Hao-Xuan/Reactor-Bike-Light/Mechanical/Media/reactor_physical.PNG

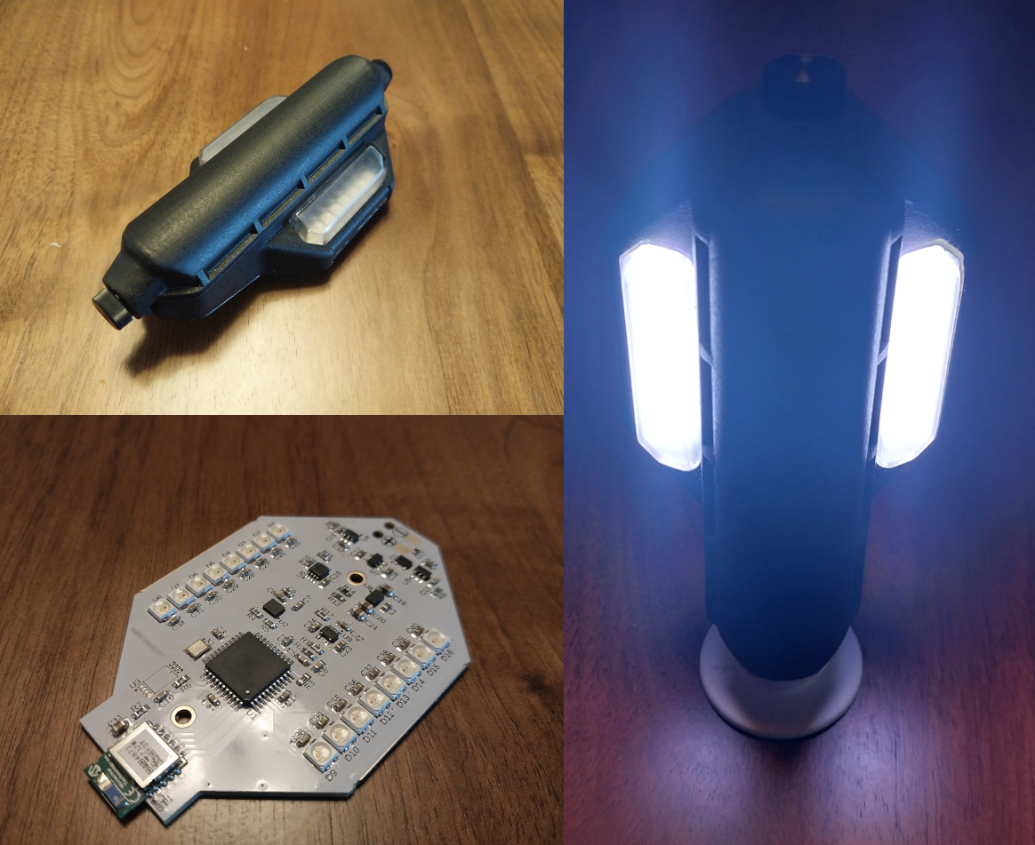
Mechanical/Media/reactor_physical.PNG
