Hao-Xuan/Reactor-Bike-Light/Electronics/Media/reactor_Prod_Dev.jpg

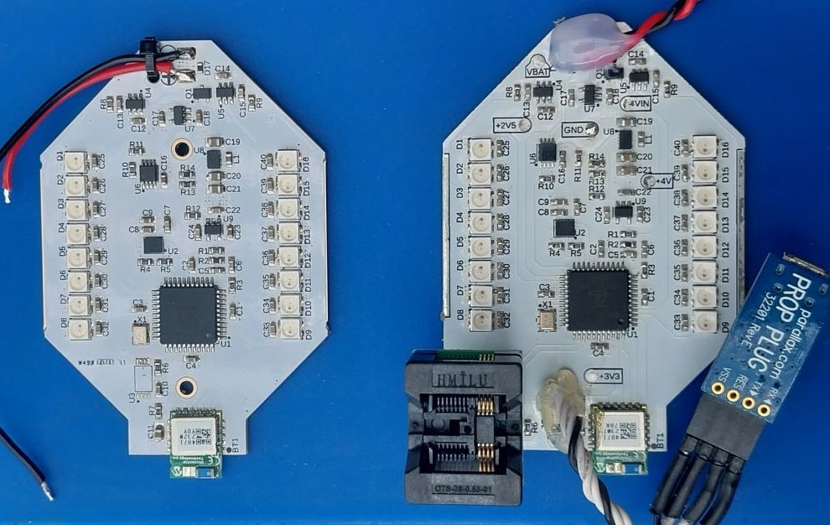
Electronics/Media/reactor_Prod_Dev.jpg
