Hao-Xuan/Reactor-Bike-Light/Electronics/readme.md

# Electronics

---
## Architecture Summary

The architecture of Reactor's electronic system was developed to support three primary responsibilities: sensing the motion of the bicycle, controlling the lighting system in real time, and communicating with external devices. These responsibilities place very different demands on the hardware. Motion sensing requires clean power and reliable timing. Wireless communication requires its own dedicated radio subsystem. High-power LED operation requires significantly more energy than the rest of the electronics combined.

To accommodate these competing requirements, the system was divided into functional subsystems organized around four power domains. This architecture simplified development and debugging while allowing the sensing, communications, control, and lighting hardware to evolve independently as the design matured. This architecture also supports Reactor's low-power operating modes by allowing portions of the system to remain active only when required.

The block diagram in Figure 1 below provides a high-level view of the electronic architecture and the relationships between its major subsystems.

reactor_Electronics_Block_Diagram

**Figure 1** - System architecture showing the four functional power domains and their major hardware subsystems

### 🔵 Power Source

The Power Source block consists of a removable lithium-ion battery and the circuitry required to safely interface that battery to the rest of the system. The removable battery design allows riders to replace depleted cells and continue riding without waiting for a recharge cycle. Input protection circuitry guards the electronics against common fault conditions and provides a stable entry point for power distribution throughout the device.

### 🟢 Always-On Domain

The Always-On Domain provides the circuitry to monitor rider input and initiate system startup. It remains powered whenever a battery is installed and operates independently of the rest of the system. This arrangement allows Reactor to remain responsive while minimizing standby power consumption, since the lighting system and control electronics only need to be energized when the rider requests them.

### 🔴 High-Power Domain

The High-Power Domain serves as the primary operating power domain for Reactor. Once activated by the Always-On Domain, it supplies power to the lighting system and to the control electronics responsible for sensing, communications, and system coordination. This arrangement allows the majority of the hardware to remain unpowered when inactive while still supporting rapid startup when rider input is detected.

### 🟡 Control Domain

The Control Domain contains the circuitry responsible for sensing, computation, communications, data storage, battery monitoring, and system coordination. It receives power from the High-Power Domain and remains active only while the lighting system is operating. This arrangement provides a stable regulated supply while ensuring that the control electronics consume no power when the system is inactive.

---
## Domain Details

### 🔵 Power Source

The Power Source block provides energy to the entire system and protects downstream electronics from battery-related fault conditions. All power enters the PCB from a battery and passes through a small protection stage before reaching the remainder of the system. Figure 2 shows the schematic snippet for both subsystems.

schematic_Power_Source

**Figure 2** - Power Source circuitry showing the removable battery interface and input protection stage

#### Removable Li-ion Battery

Reactor is powered by a single rechargeable lithium-ion cell in the 18650 form factor. The 18650 was selected for its combination of energy density, availability, low cost, and well-established ecosystem of chargers and replacement cells.

A removable battery was chosen instead of an integrated rechargeable pack to improve usability during normal operation. Riders can carry spare cells and replace a depleted battery in seconds rather than waiting for the device to recharge. This approach also simplifies long-term maintenance, since battery capacity naturally degrades over time and replacement does not require disassembling the electronics.

#### PCB Input Protection

The PCB Input Protection subsystem forms the interface between the battery and the rest of Reactor's electronics. Battery voltage first passes through a transient voltage suppression diode that protects the circuit from electrostatic discharge events that may occur during battery handling, insertion, or removal.

Because Reactor uses removable batteries, incorrect installation must be considered a normal operating scenario rather than an exceptional event. A power MOSFET configured for reverse-polarity protection prevents damage if a battery is installed incorrectly.

The protected output of this stage appears at `VIN`, which serves as the entry point for the remainder of Reactor's power distribution system.

### 🟢 Always-On Domain

The Always-On Domain provides the circuitry required for Reactor to remain responsive while inactive. Unlike the remainder of the system, which is unpowered when the bike light is off, the Always-On Domain remains active whenever a battery is installed. The Always-On Domain consists of two primary subsystems: the touch sensing circuitry used to detect rider input and the wakeup logic responsible for enabling the rest of the electronic system. Figure 3 shows the schematic snippet for the Always-On Domain.

schematic_Always_On

**Figure 3** - Always-On Domain showing standby power, touch sensing, and wakeup logic

#### Power Distribution

The Always-On Domain is powered by a dedicated 2.5V supply generated directly from the lithium-ion battery through a low-dropout linear regulator which is always enabled. A regulator was selected to maximize the usable battery discharge range while minimizing standby power consumption. Its low quiescent current allows the Always-On Domain to remain active for extended periods without significantly affecting battery life, while providing sufficient dropout margin to maintain regulation throughout the normal operating range of a single lithium-ion cell.

#### Dual Touch Sensors

Rider input is detected by dual sensing pads integrated into the left and right sides of the PCB and bonded  to the inside of the mechanical enclosure. Each pad is continuously monitored by a dedicated touch controller IC that produces a digital output when a touch is detected. These outputs appear as the `TOUCH_A` and `TOUCH_B` signals, which are used by the Always-On Domain to initiate system startup and later by firmware to interpret rider commands.

Capacitive sensing was selected because it provides a sealed user interface with no mechanical buttons or switches. This improves durability in outdoor environments and eliminates openings that would otherwise complicate weather resistance.

#### Wakeup Logic

The Wakeup Logic subsystem controls the transition between Reactor's standby and operating states.

A simultaneous touch on both sensing pads generates the `+4V_EN` signal, enabling the High-Power Domain. Requiring both sensors to be activated reduces the likelihood of accidental startup while still providing a simple power-on gesture. Once the system has started, control of the power state is transferred to firmware through the `POWER_EN` signal. This allows the microcontroller to keep the system powered after the original touch event has ended and later return the device to standby when appropriate.

By separating wakeup detection from normal operation, Reactor remains responsive while consuming very little power when inactive. The rider experiences immediate startup, while the majority of the electronics remain unpowered until needed.

### 🔴 High-Power Domain

The High-Power Domain provides the regulated power required for normal system operation. Once enabled by the Always-On Domain, it supplies energy to both the lighting system and the control electronics responsible for sensing, communications, and system coordination.

In addition to power conversion, this domain manages the startup sequence that brings the remainder of the system online and ensures that downstream circuitry receives stable operating voltages across the full battery discharge range. Figure 4 shows the schematic snippet for the High-Power Domain power distribution circuitry.

schematic_High_Power_Regulator

**Figure 4** - High-Power Domain power distribution and startup sequencing
#### Power Distribution

The High-Power Domain is enabled through the `+4V_EN` signal generated by the Always-On Domain. Once asserted, a buck/boost regulator produces the primary 4.0V supply that powers both LED arrays directly.

A buck/boost topology was selected because the voltage of a single lithium-ion cell varies substantially throughout its normal discharge cycle. This allows the regulator to maintain a constant 4.0V output whether the battery voltage is above or below the target net voltage, ensuring consistent LED performance across the full operating range of the battery.

In addition to powering the LED arrays, the regulated 4.0V regulator supplies the downstream 3.3V regulator that supplies the Control Domain.

#### Dual LED Arrays

The lighting system consists of two independent chains of addressable RGB LEDs. Each array contains eight LEDs and is controlled independently by firmware through dedicated single-wire serial data connections `LED_A` and `LED_B`. Figure 5 shows the schematic snippet for both LED arrays.

schematic_High_Power_LEDs

**Figure 5** - Dual independently controlled addressable LED arrays

Addressable LEDs were selected because they integrate the LED drivers and communication interface into a single package. This significantly reduces component count and routing complexity compared to a discrete LED implementation, while providing individual color and brightness control of every LED. The resulting flexibility allows a single hardware platform to support head, tail, and ground light modes as well as brake, turn, and hazard indications entirely through firmware.

The arrays are powered directly from the regulated 4.0V supply and arranged as independent serial chains, allowing each array to operate independently when required. Each LED includes local bypass capacitance to reduce supply disturbances caused by rapid switching of the internal LED drivers.

### 🟡 Control Domain

The Control Domain contains the circuitry responsible for sensing, computation, communications, persistent storage, and battery monitoring. Operating from the regulated 3.3V supply, it serves as the central coordination point for Reactor's electronic system.

At its heart is a multicore microcontroller that acquires sensor data, executes the control algorithms, manages wireless communications, stores configuration data, monitors battery condition, and generates the commands transmitted to the LED arrays. Supporting peripherals provide motion sensing, wireless connectivity, non-volatile storage, and battery measurement capabilities.

#### Power Distribution

The Control Domain is powered from a dedicated 3.3V low-noise linear regulator sourced from the High-Power Domain's 4.0V supply. This regulator provides a clean, stable supply for the microcontroller, inertial measurement unit, wireless communications module, battery monitor, and persistent memory. Figure 6 shows the schematic snippet for the Control Domain power supply.

schematic_Control_Domain_LDO

**Figure 6** - Control Domain 3.3 V power distribution and startup sequencing

The 3.3 V regulator is enabled by the ``+3V3_EN`` signal, which is driven by the power-good (PG) output of the 4 V regulator. During 4 V startup, the PG output is held low, keeping the 3.3 V regulator disabled. Once the 4 V output has stabilized, PG releases to its open-drain state and an external pull-up resistor drives ``+3V3_EN`` high, enabling the 3.3 V regulator.

#### Microcontroller

The microcontroller coordinates every function within Reactor's electronic system. It receives sensor data from the inertial measurement unit, processes rider input from the touch sensors, manages wireless communications, monitors battery condition, retrieves configuration data from non-volatile memory, and generates lighting commands for the LED arrays. Figure 6 shows the microcontroller and its supporting circuitry, including the external crystal oscillator and local decoupling network required for reliable operation.

schematic_Control_Domain_MCU

**Figure 7** - Propeller microcontroller and supporting circuitry

The Propeller P8X32A serves as the central controller for Reactor. The device provides eight independent processing cores that share access to memory and I/O resources, allowing sensing, communications, lighting control, and system management tasks to execute concurrently.

Unlike most modern microcontrollers, the Propeller provides only a minimal set of hardware peripherals. As a result, many low-level system functions were implemented directly in software. Communication interfaces, LED signaling, timing infrastructure, battery measurement, and subsystem coordination were all developed as bare-metal firmware components tailored to the requirements of the project.

This approach required a deeper understanding of both the hardware and firmware layers of the system but also provided complete control over timing behavior and resource allocation. The resulting architecture allowed motion sensing, wireless communications, power management, and lighting control to operate simultaneously while maintaining deterministic system behavior.

#### Inertial Measurement

The inertial measurement unit (IMU) provides the motion data that allows Reactor to respond automatically to changing riding conditions. It continuously measures linear acceleration and angular velocity, providing the information required to detect braking, turning, crashes, and changes in bicycle orientation. Figure 7 shows the IMU and its supporting circuitry.

schematic_Control_Domain_IMU

**Figure 8** - Inertial measurement subsystem

The IMU communicates with the microcontroller over an I²C interface and serves as the primary sensing device within Reactor. An interrupt output provides a dedicated hardware signal for communicating time-critical events to the microcontroller, while pull-up resistors on the I²C bus ensure reliable communication between the two devices.

Because many of Reactor's safety features depend on accurate motion measurements, the IMU was supplied by the dedicated low-noise 3.3 V regulator within the Control Domain. Local decoupling capacitors were placed adjacent to the device to maintain a stable supply during operation and minimize high-frequency supply disturbances.

The hardware provides only the raw motion data. Filtering, sensor fusion, coordinate transformations, and motion classification algorithms that convert these measurements into lighting behavior are implemented entirely in firmware and are described in the Firmware documentation.

#### Radio Communications

The Bluetooth Low Energy (BLE) subsystem provides wireless communication between Reactor and the companion mobile application. Through this interface, riders can configure device behavior, monitor battery status, and receive crash notifications without requiring a wired connection. Figure 8 shows the BLE module and its supporting circuitry.

schematic_Control_Domain_BLE

**Figure 9** - Bluetooth Low Energy communications subsystem

Wireless communication is provided by a self-contained BLE module that integrates the radio, protocol stack, and application processor into a single package. Using a pre-certified module significantly reduced hardware complexity and eliminated the need to develop a custom RF design.

The module communicates with the microcontroller through a UART interface. A dedicated`BLE_RST` signal allows firmware to place the module in a known state during startup and recover from communication faults if necessary. Two configurable GPIO outputs are connected to the microcontroller as`BLE_P1_6` and`BLE_P1_7`, providing simple hardware status signals that reduce firmware polling overhead. The remaining module I/O pins are unused and tied to their recommended default states in accordance with the manufacturer's reference design.

#### Battery Monitor

The Battery Monitor subsystem measures battery voltage so firmware can estimate remaining charge, report battery status to the rider, and notify the rider when the battery requires replacement or recharging. Figure 9 shows the analog front-end used to interface the battery to the microcontroller.

schematic_Control_Domain_ADC

**Figure 10** - Battery monitoring analog front-end

Battery voltage is reduced to a safe measurement range by a resistor divider before being presented to the microcontroller. RC filtering removes high-frequency noise and switching transients from the supply, improving measurement stability during normal operation.

Because the Propeller P8X32A does not include a hardware analog-to-digital converter, battery voltage is measured using the device's built-in sigma-delta counter mode. The filtered divider output is connected to the measurement input `ADC_M`, while a second GPIO `ADC_P` provides the feedback signal required by the sigma-delta conversion circuit. This approach provides a simple, low-cost method of measuring battery voltage without requiring an external ADC.

#### Persistent Memory

The Persistent Memory subsystem provides non-volatile storage for both Reactor's application firmware and user configuration data. Unlike many modern microcontrollers, the Propeller P8X32A contains no internal program flash. Instead, its built-in bootloader retrieves the application image from an external I²C EEPROM during every system startup. Figure 10 shows the EEPROM interface circuitry.

schematic_Control_Domain_EEPROM

**Figure 11** - Persistent memory subsystem

The EEPROM is connected to the microcontroller through a dedicated I²C interface that is separate from the inertial measurement unit. This isolates program memory accesses from motion sensor communications while allowing firmware to read and write persistent data whenever required.

A dual-bank EEPROM was selected to support safe firmware updates. New firmware images are written to the inactive memory bank before replacing the active application, reducing the risk of rendering the device inoperable if power is interrupted during the update process.

In addition to storing the application firmware, unused EEPROM space is used to retain configuration data across power cycles. Rider preferences, lighting configuration, and other operating parameters remain intact even when the battery is removed, eliminating the need to reconfigure the device after normal battery replacement.

---
## PCB Layout

The Reactor PCB was designed as a compact four-layer board that integrates the lighting, sensing, power management, and communications subsystems into a single assembly. Component placement, routing, power distribution, and thermal management were considered together to support reliable operation while conforming to the mechanical constraints of the enclosure. The resulting layout separates high-current lighting circuitry from the control electronics while providing continuous ground planes, dedicated internal power distribution, and integrated capacitive touch electrodes. Figure 12 shows the annotated view of this layout.

PCB_Annotated

| Domain | Reference | Module |
|:---|:---:|:---|
| 🔵 **Power Source** | **P1** | Removable Li-ion Battery |
| 🔵 **Power Source** | **P2** | PCB Input Protection |
| 🟢 **Always-On** | **A1** | Always-On Supply |
| 🟢 **Always-On** | **A2** | Dual Touch Sensors |
| 🟢 **Always-On** | **A3** | Wakeup Logic |
| 🔴 **High-Power** | **H1** | High-Power Supply |
| 🔴 **High-Power** | **H2** | Dual LED Arrays |
| 🟡 **Control** | **C1** | Control Supply |
| 🟡 **Control** | **C2** | Battery Monitor |
| 🟡 **Control** | **C3** | Microcontroller |
| 🟡 **Control** | **C4** | Radio Communications |
| 🟡 **Control** | **C5** | Inertial Measurement |
| 🟡 **Control** | **C6** | Persistent Memory |

**Figure 12** - Annotated PCB layout showing the locations of the major electronic subsystems

### Layer 1 – Component Placement and Signal Routing

pcb_Layout_Full_Top

**Figure 13** - Top layer showing component placement, signal routing, and battery power distribution

The top layer contains all components, all signal routing, and the battery power distribution. Additionally, the touch sensor electrodes are integrated into the right and left sides of the PCB and wrap around the sides to the bottom layer. Keeping every signal on a single layer simplified routing, eliminated vias on critical interfaces, and provided complete control over return current paths through the adjacent ground plane.

Component placement follows the functional partitioning established in the schematic. Power conversion circuitry is located near the battery input, the control electronics occupy the center of the board, and the LED arrays are positioned along the perimeter to maximize optical coverage while minimizing routing complexity.

### Layer 2 – Ground Plane

pcb_Layout_Full_L2

**Figure 14** - Layer 2 dedicated ground plane

The second layer is dedicated almost entirely to an uninterrupted ground plane. Providing a continuous return plane directly beneath the signal layer improves signal integrity, minimizes loop area, and reduces susceptibility to switching noise from the power electronics. The solid copper area also contributes significant thermal spreading, distributing heat generated by the LED arrays and power converters across the PCB.

### Layer 3 – Power Distribution

pcb_Layout_Full_L3

**Figure 15** - Layer 3 regulated power distribution

The third layer distributes the regulated 2.5V, 3.3V, and 4.0V supply domains throughout the board. Separating power distribution from signal routing reduces routing congestion while allowing each supply domain to be delivered with low impedance to its respective circuitry. The wide copper regions also contribute additional thermal mass, helping conduct heat toward the enclosure and the steel mounting pins.

### Layer 4 – Ground Plane

pcb_Layout_Full_Bottom

**Figure 16** - Bottom layer dedicated ground plane

The bottom layer provides a second continuous ground plane. Together with Layer 2, it forms a low-impedance return path for the entire system while improving electromagnetic performance and increasing the board's overall thermal conductivity. The dual-plane arrangement also increases mechanical rigidity despite the relatively thin PCB profile required by the enclosure. Additionally, the edge-plated touch sensor electrodes extend into the bottom layer.

---
## Testing & Validation

The Reactor electronics were validated progressively throughout development, beginning with the power-input circuitry and individual regulated domains and culminating in complete system bring-up and thermal testing. The development PCB provided access to programming interfaces and test points that were intentionally omitted from the sealed production hardware.

reactor_Prod_Dev

**Figure 17** - Production (left) and development (right) versions of the Reactor electronics. The development board preserves the production electrical design while adding programming and validation hardware, including firmware download, EEPROM programming, power-domain monitoring, and subsystem bring-up support. Production boards are assembled, programmed, functionally verified, and then sealed into the final enclosure.

### Development Hardware

Hardware development was performed using a dedicated development version of the Reactor PCB. Electrically, this board is identical to the production hardware, but incorporates several features intended to simplify development, validation, and manufacturing. A PropPlug programming interface provides direct access to the microcontroller during firmware development, while a removable EEPROM programming socket allows non-volatile memory devices to be programmed before installation on production boards. Dedicated test points expose each regulated supply rail and other critical signals, allowing rapid verification of power sequencing and subsystem operation during board bring-up.

Because the production electronics are permanently sealed inside the enclosure, these development features were intentionally omitted from the final hardware after validation. The development board therefore served as the primary platform for hardware bring-up, firmware development, electrical characterization, and production EEPROM programming throughout the project.

### Board Bring-Up

#### Power Source

Assembly began with the battery input circuitry, including the input protection network and battery connector. The board was initially powered from a current-limited bench supply configured to emulate a lithium-ion cell, allowing input current to be monitored while verifying the integrity of the battery input path. The protected power bus was also connected to the external breadboard, which provided temporary switches, LEDs, and other simple interfaces used during bring-up.

#### High-Power Domain

The buck/boost regulator and its supporting circuitry were assembled next, including the regulator enable circuitry and its pull-down resistor. During initial power-supply bring-up, the regulator's enable input was controlled by a simple toggle-switch circuit on the external breadboard. This provided convenient manual control of the 4.0 V supply without requiring the touch sensors or wakeup logic to be operational.

The regulator was exercised under bench power while verifying the 4.0 V supply, regulator startup behavior, and power-good sequencing. Temporary LED loads on the breadboard were used to characterize regulator performance under representative operating conditions before any high-power lighting hardware was installed on the PCB.

#### Control Domain

With the power supply operating reliably, the Control Domain was assembled around the microcontroller. Once the 3.3 V supply was verified, simple firmware validation routines were used to confirm processor startup, external memory operation, inertial measurement unit communication, battery monitoring, wireless communication, and LED driver operation. Individual peripherals were exercised independently before integrating the complete control system, allowing hardware and firmware development to proceed in parallel while maintaining confidence in each subsystem.

#### Always-On Domain

The Always-On Domain was assembled and validated after the Control Domain. The 2.5 V standby supply was verified along with the touch sensors and wakeup logic responsible for controlling the High-Power Domain. These circuits were then integrated with the previously validated power-supply circuitry, replacing the temporary breadboard toggle with the Reactor's actual wakeup and power-latch mechanism.

#### Onboard LED Arrays

Only after the power, control, and wakeup systems had been validated were the onboard LED arrays installed. Delaying installation of the production lighting hardware minimized debugging complexity and ensured that any remaining issues could be isolated to the lighting circuitry itself.

### Startup Sequence Validation

The power-up sequence was verified with oscilloscope measurements of the power-control signals and supply rails. The composite capture below shows the five key events in the transition from the OFF state to normal operation.

1. **`+4V_EN` asserted** — A simultaneous touch of both sensors initiates the hardware wakeup sequence, causing `+4V_EN` to be asserted and enabling the 4.0 V supply.

2. **4 V rail reaches regulation** — The 4.0 V rail rises to its regulated output, after which its open-drain `PG` output is released.

3. **`+3V3_EN` asserted** — The now high-impedance `PG` output allows `+3V3_EN` to be pulled high, enabling the 3.3 V regulator.

4. **3.3 V rail reaches regulation** — The 3.3 V rail rises to its operating voltage, providing power to the MCU and the remaining switched electronics.

5. **`POWER_EN` asserted** — Firmware asserts `POWER_EN` low, latching the system in the ON state. The touch sensors can then be released without interrupting power.

Startup_Sequence

**Figure 18** - Oscilloscope captures validating the Reactor power-up sequence, showing the five sequential transitions from +4V_EN assertion through PWR_EN assertion and system power-latch.

The measured sequence occurs on multiple time scales. The initial transitions between the power-control signals and supply rails occur within tens to hundreds of microseconds, while the final transition to the latched ON state occurs on a much longer time scale. From the initial wakeup event to assertion of `POWER_EN`, the complete startup sequence takes approximately 1 second.

The measurements confirm that each power stage is enabled in the intended order and that the system does not proceed to the next stage until the preceding supply has reached a valid operating condition. This provides a controlled transition from the always-on 2.5 V domain to the switched 4.0 V and 3.3 V domains while allowing the initial touch gesture to be released once firmware has taken control of the power latch.

### Thermal Performance and Temperature Regulation

Thermal performance was evaluated using a controlled static bench test of three Reactor units. Each unit was operated individually in Head (H), Ground (G), and Tail (T) modes under three cooling conditions: ambient (A) cooling by natural convection, low-fan (L) cooling using a low level of forced airflow, and high-fan (F) cooling using a higher level of forced airflow. The tests were performed indoors at an ambient temperature of approximately 27 °C. The progressively higher fan settings were used to examine how additional airflow affected the thermal behavior of the system.

Figure 19 shows the resulting temperature measurements. The three Reactor units exhibit consistent thermal behavior within each operating mode. Head mode produces the highest temperatures, while Ground and Tail modes operate substantially cooler.

Temp (C) vs Time (min)

**Figure 19** - Temperature versus time for three Reactor units tested in Head, Ground, and Tail modes under ambient, low-fan, and high-fan cooling conditions.

The most significant result is the repeatable temperature regulation observed in Head mode. Under ambient cooling, all three units converge to a narrow operating range of approximately 59–60 °C. Once this temperature range is reached, the traces exhibit small, regular changes in temperature as the firmware's thermal regulation adjusts LED output in response to the measured temperature. The similar behavior observed across all three units demonstrates that the thermal regulation mechanism operates consistently between units rather than depending on the characteristics of an individual board.

Forced airflow substantially lowers the operating temperature of the Reactor. Low-fan operation reduces the Head-mode temperature to approximately the low-to-mid 50 °C range, while the high-fan condition produces a further reduction in some cases. The difference between the two fan settings is less pronounced than the difference between forced airflow and ambient cooling, indicating that additional airflow provides diminishing thermal benefit once sufficient cooling is available.

Ground and Tail modes remain substantially cooler than Head mode under all three cooling conditions. This is consistent with their lower LED power levels and further demonstrates that the thermal-control system is primarily exercised under the highest-load Head-mode condition.

These bench tests provide validation that Reactor's thermal behavior is repeatable across multiple units and that the firmware's temperature regulation maintains a controlled operating range under the highest-power lighting condition. The controlled cooling experiments also demonstrate that the system responds predictably to changes in available airflow. Static bench testing does not, however, reproduce the complete thermal environment of a moving bicycle; real-world cooling performance will therefore be evaluated separately through road testing.

---
