Hao-Xuan/Reactor-Bike-Light/Device Firmware/Media/reactor_architecture.PNG

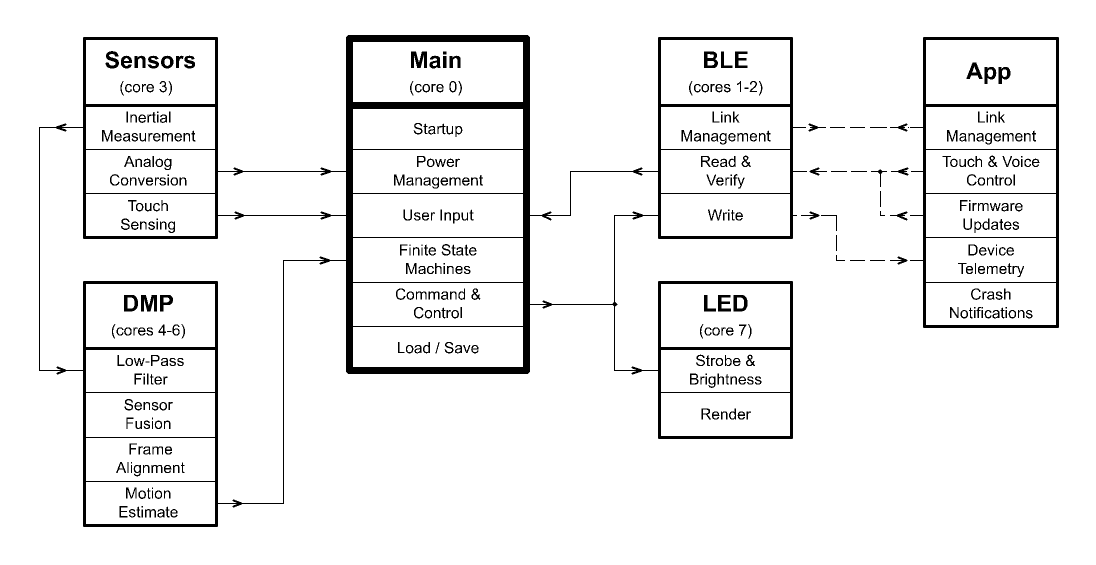
Device Firmware/Media/reactor_architecture.PNG
