Hao-Xuan/Reactor-Bike-Light/Device Firmware/Media/reactor_fir_lowpass.PNG

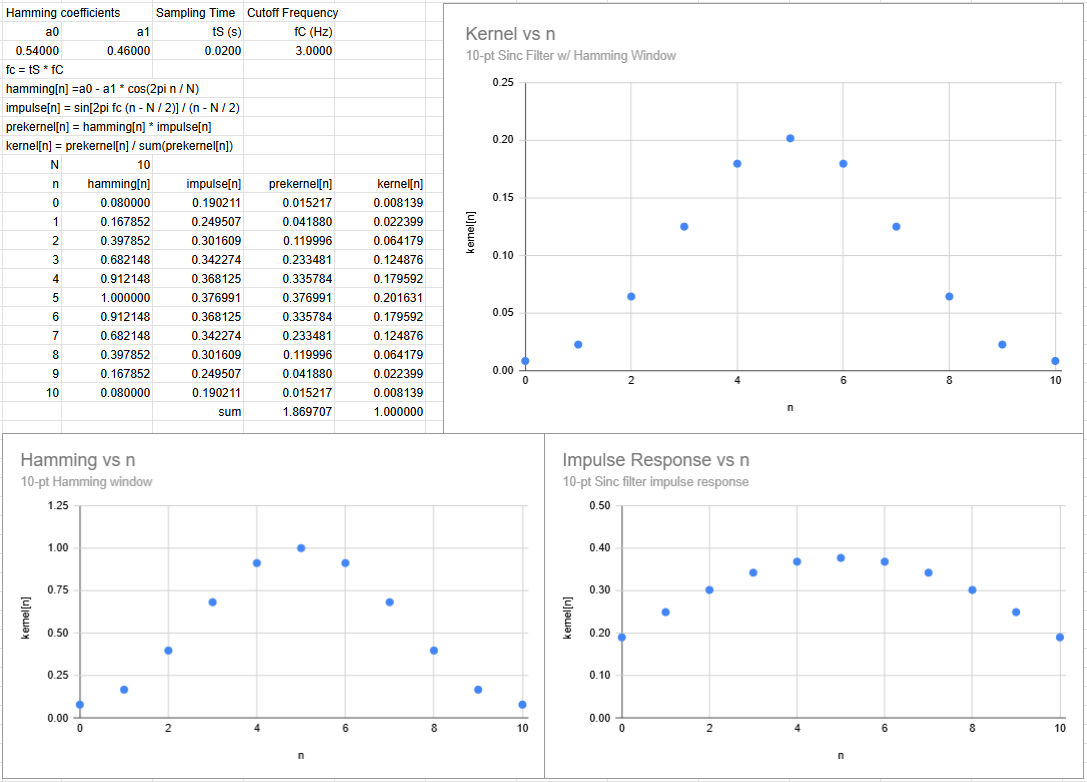
Device Firmware/Media/reactor_fir_lowpass.PNG
