Hao-Xuan/Reactor-Bike-Light/Electronics/Media/PCB_Annotated.png

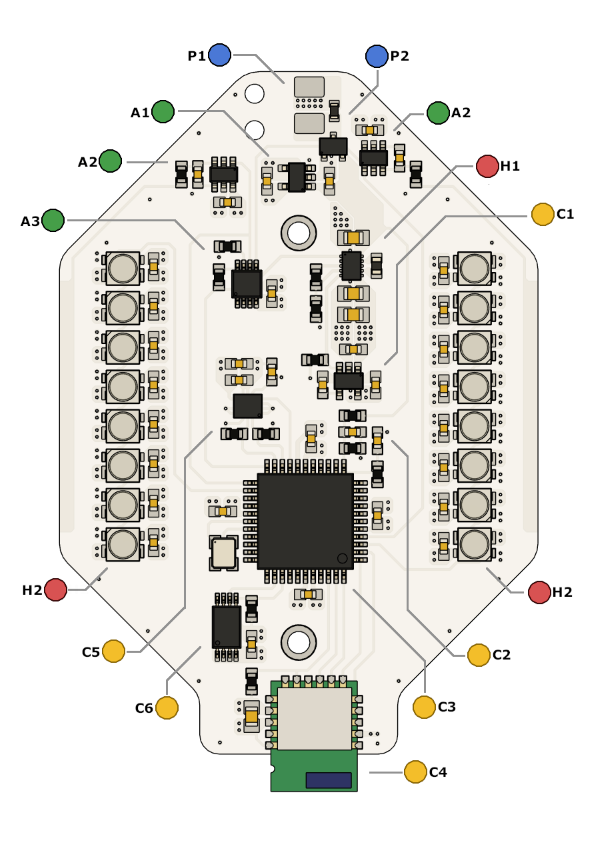
Electronics/Media/PCB_Annotated.png
