Hao-Xuan/Reactor-Bike-Light/Electronics/Media/pcb_Layout_Full_Bottom.PNG

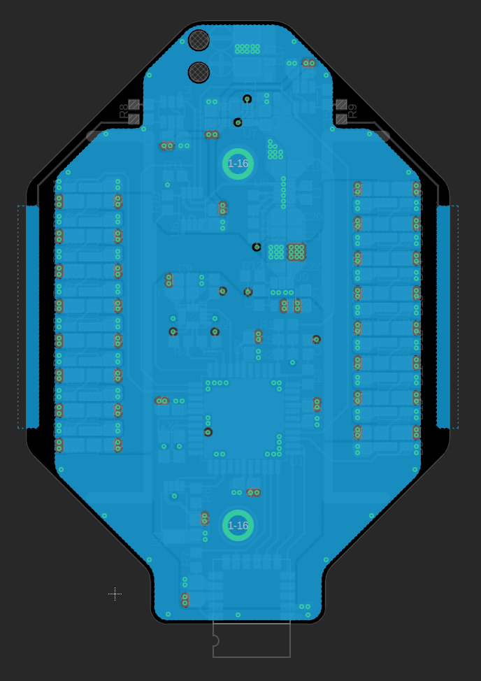
Electronics/Media/pcb_Layout_Full_Bottom.PNG
