Hao-Xuan/Reactor-Bike-Light/Electronics/Media/pcb_Layout_Full_L2.PNG

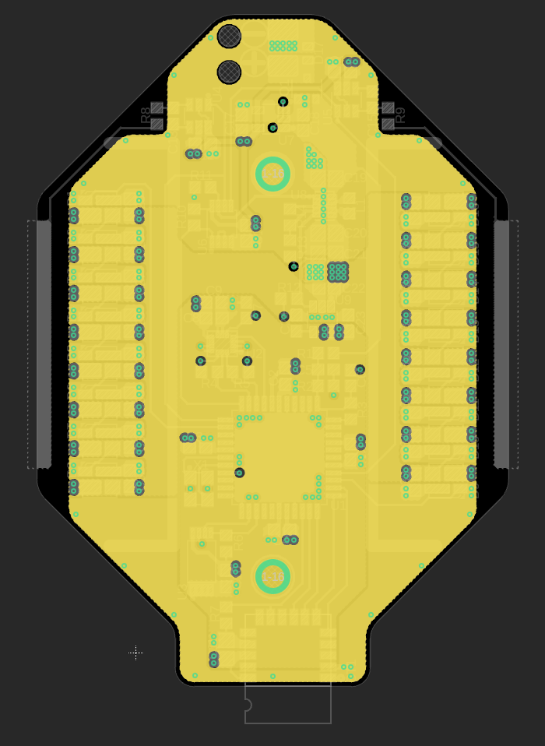
Electronics/Media/pcb_Layout_Full_L2.PNG
