Hao-Xuan/Reactor-Bike-Light/Electronics/Media/pcb_Layout_Full_Top.PNG

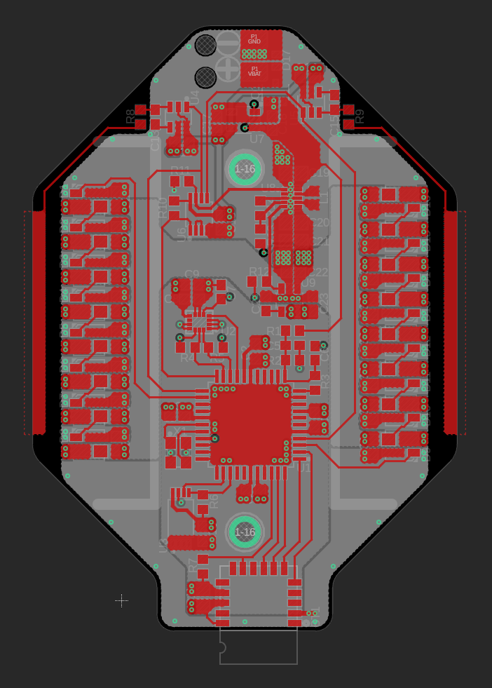
Electronics/Media/pcb_Layout_Full_Top.PNG
