Hao-Xuan/Reactor-Bike-Light/Electronics/Media/reactor_Electronics_Block_Diagram.PNG

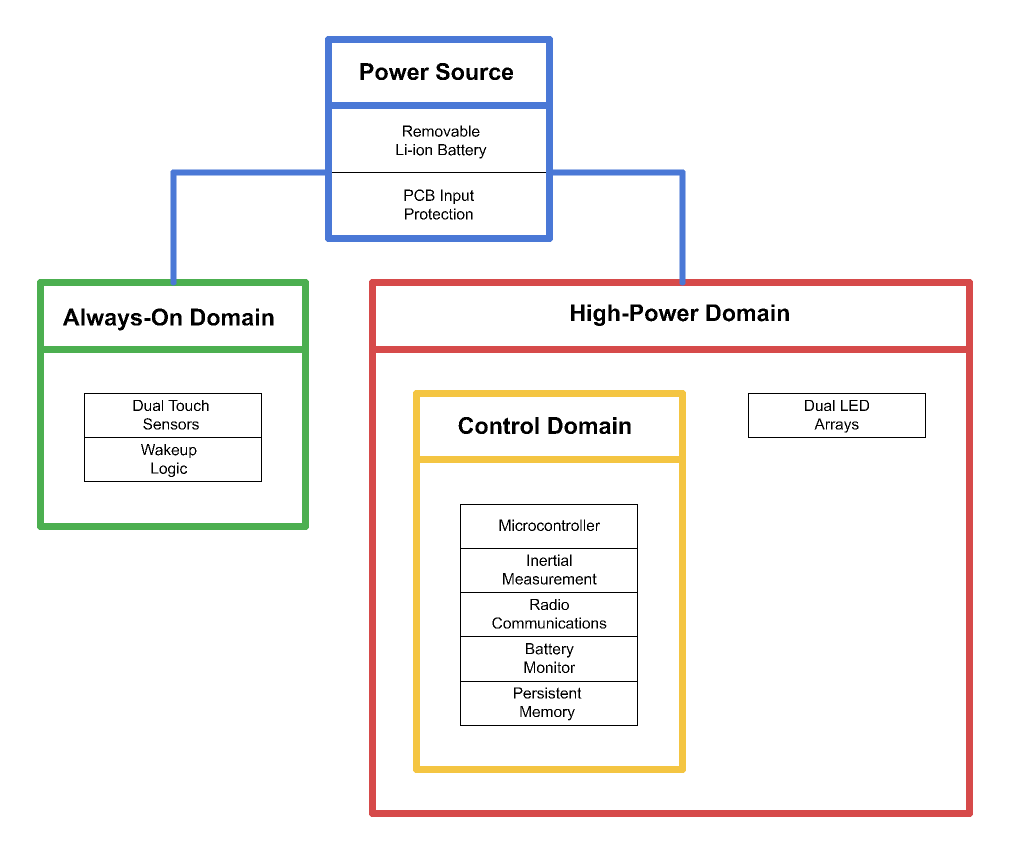
Electronics/Media/reactor_Electronics_Block_Diagram.PNG
