Hao-Xuan/Reactor-Bike-Light/Electronics/Media/schematic_Always_On.PNG

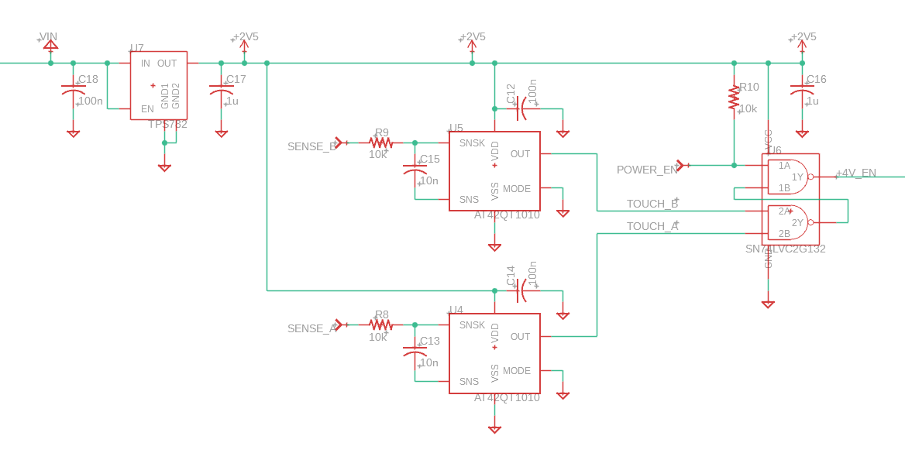
Electronics/Media/schematic_Always_On.PNG
