Hao-Xuan/Reactor-Bike-Light/Electronics/Media/schematic_Control_Domain_ADC.PNG

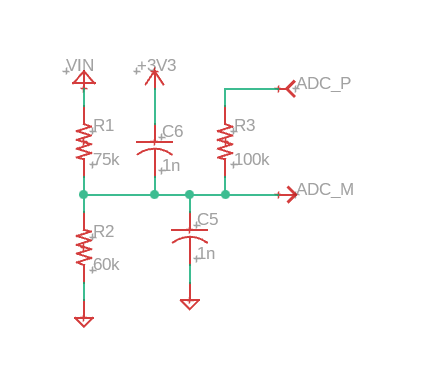
Electronics/Media/schematic_Control_Domain_ADC.PNG
