Hao-Xuan/Reactor-Bike-Light/Electronics/Media/schematic_Control_Domain_BLE.PNG

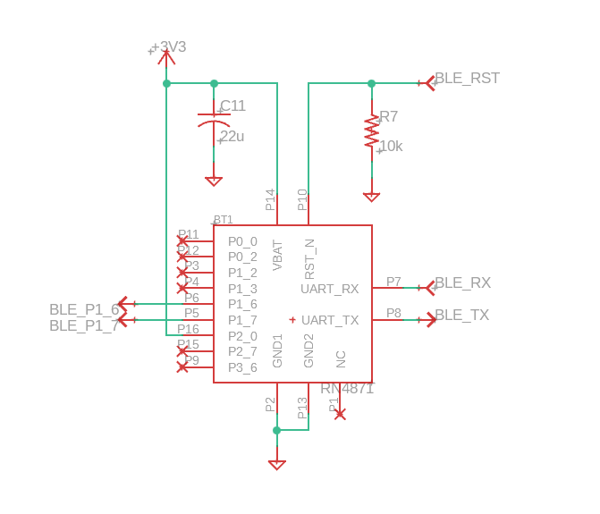
Electronics/Media/schematic_Control_Domain_BLE.PNG
