Hao-Xuan/Reactor-Bike-Light/Electronics/Media/schematic_Control_Domain_EEPROM.PNG

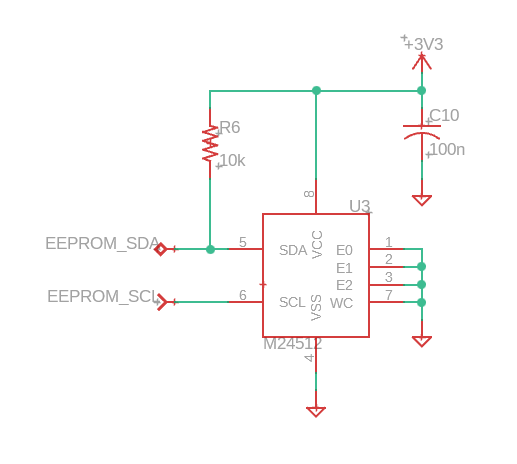
Electronics/Media/schematic_Control_Domain_EEPROM.PNG
