Hao-Xuan/Reactor-Bike-Light/Electronics/Media/schematic_Control_Domain_IMU.PNG

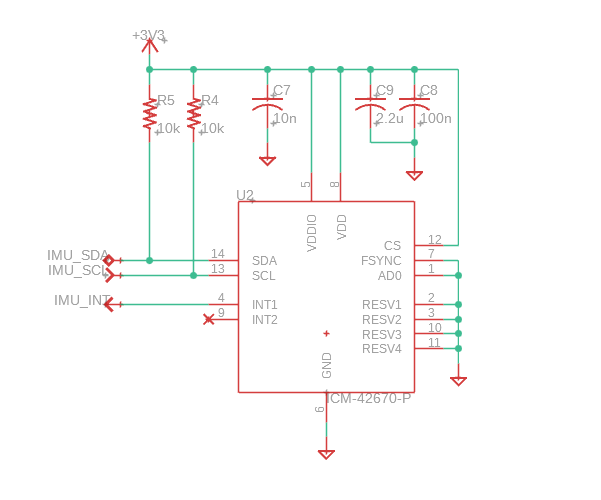
Electronics/Media/schematic_Control_Domain_IMU.PNG
