Hao-Xuan/Reactor-Bike-Light/Electronics/Media/schematic_Control_Domain_LDO.PNG

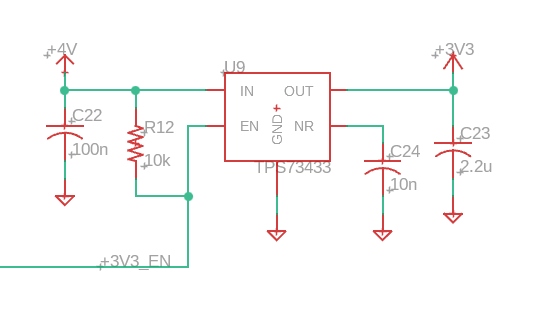
Electronics/Media/schematic_Control_Domain_LDO.PNG
