Hao-Xuan/Reactor-Bike-Light/Electronics/Media/schematic_Control_Domain_MCU.PNG

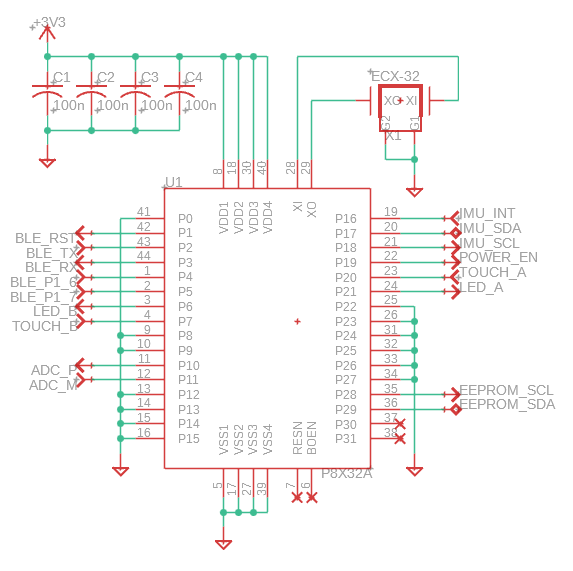
Electronics/Media/schematic_Control_Domain_MCU.PNG
