Hao-Xuan/Reactor-Bike-Light/Electronics/Media/schematic_High_Power_LEDs.PNG

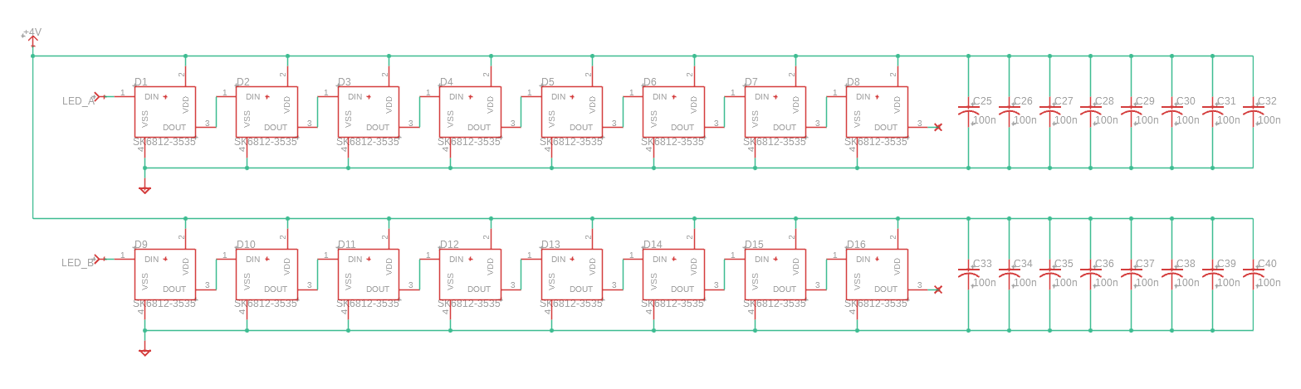
Electronics/Media/schematic_High_Power_LEDs.PNG
