Hao-Xuan/Reactor-Bike-Light/Electronics/Media/schematic_High_Power_Regulator.PNG

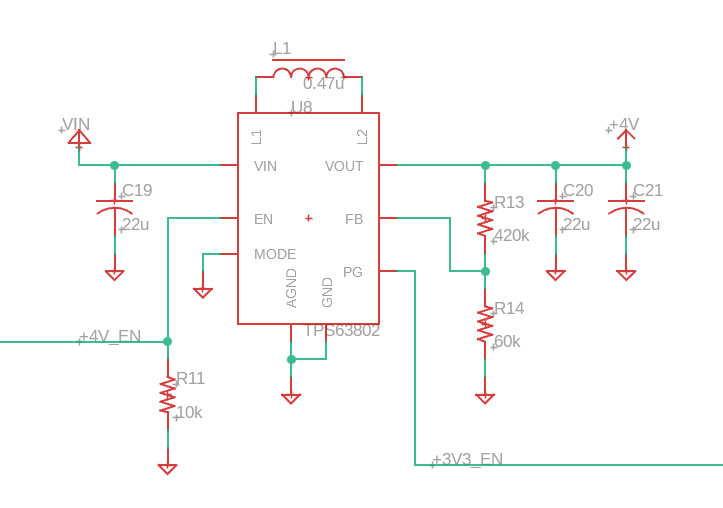
Electronics/Media/schematic_High_Power_Regulator.PNG
