Hao-Xuan/Reactor-Bike-Light/Electronics/Media/schematic_Power_Source.PNG

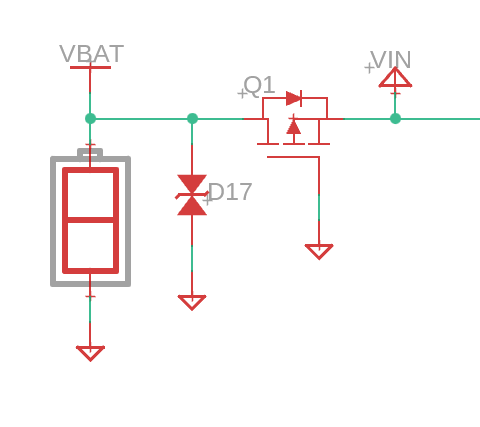
Electronics/Media/schematic_Power_Source.PNG
