Hao-Xuan/Reactor-Bike-Light/Electronics/Media/Startup_Sequence.png

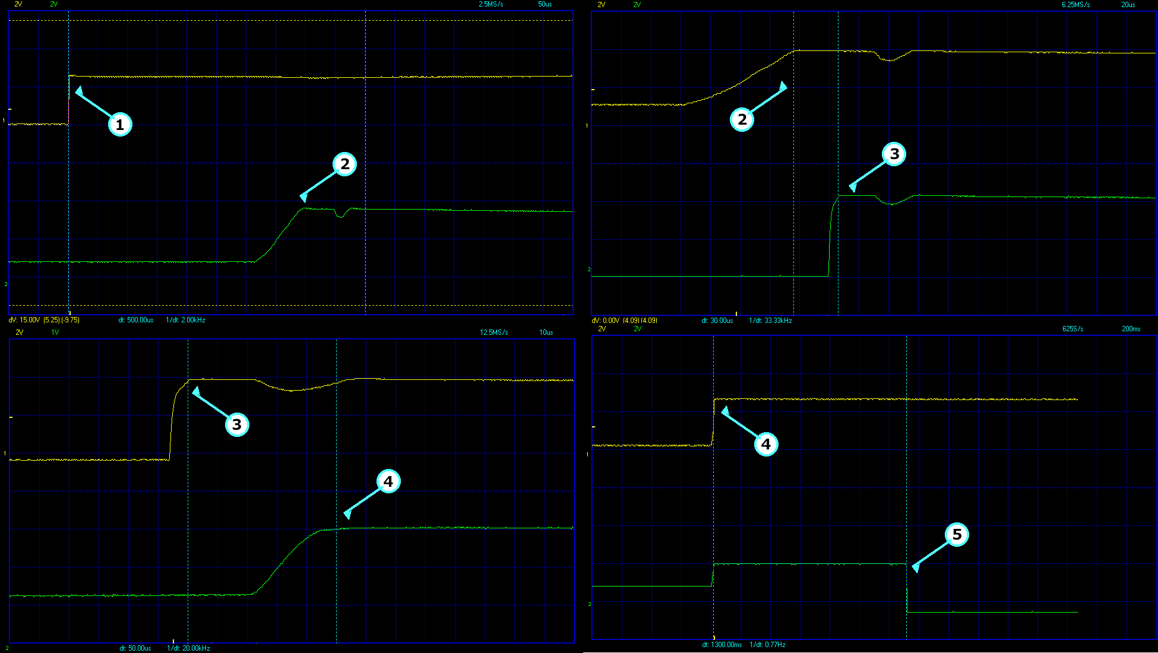
Electronics/Media/Startup_Sequence.png
