Hao-Xuan/Reactor-Bike-Light/Electronics/Media/Temp (C) vs Time (min).png

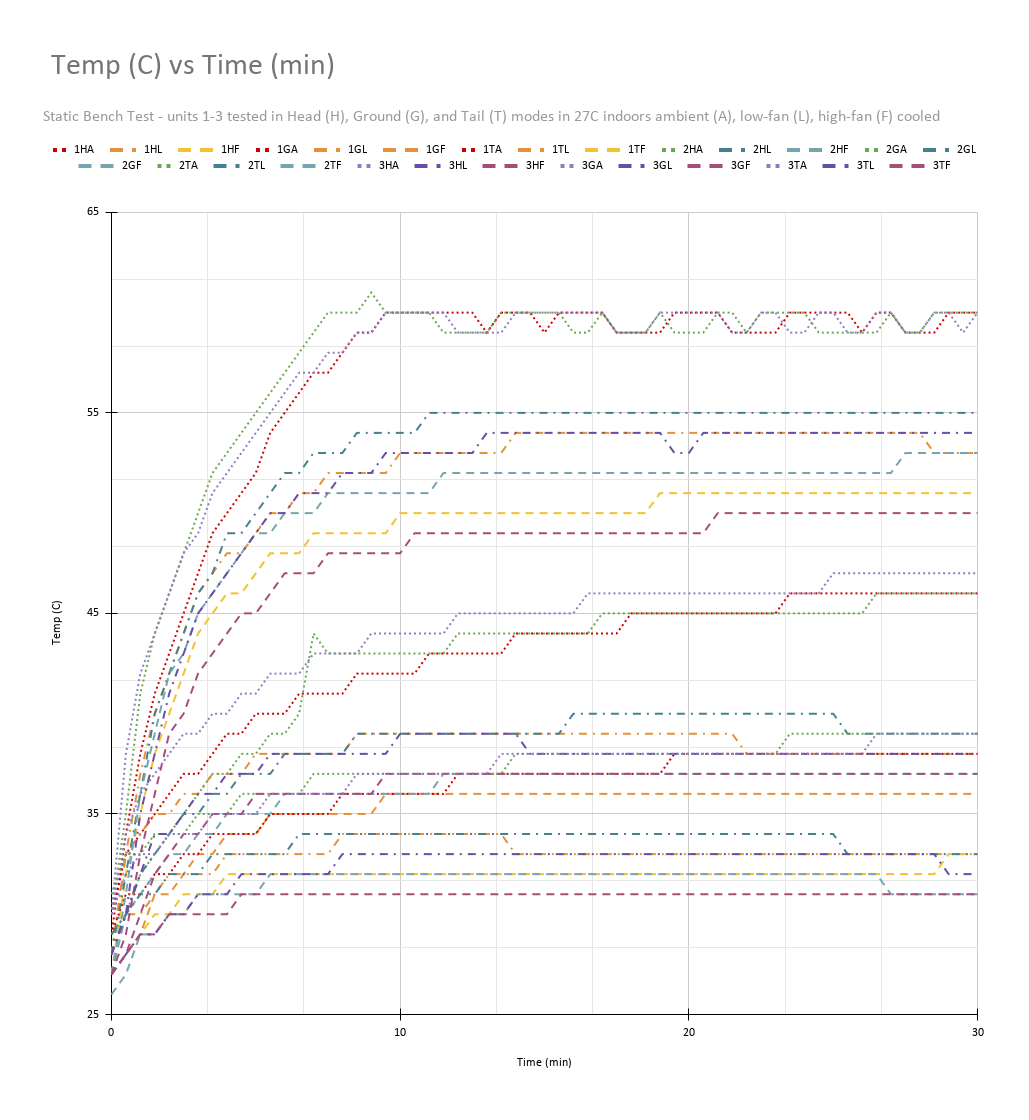
Electronics/Media/Temp (C) vs Time (min).png
