Hao-Xuan/Reactor-Bike-Light/Mechanical/Media/render_enclosure.PNG

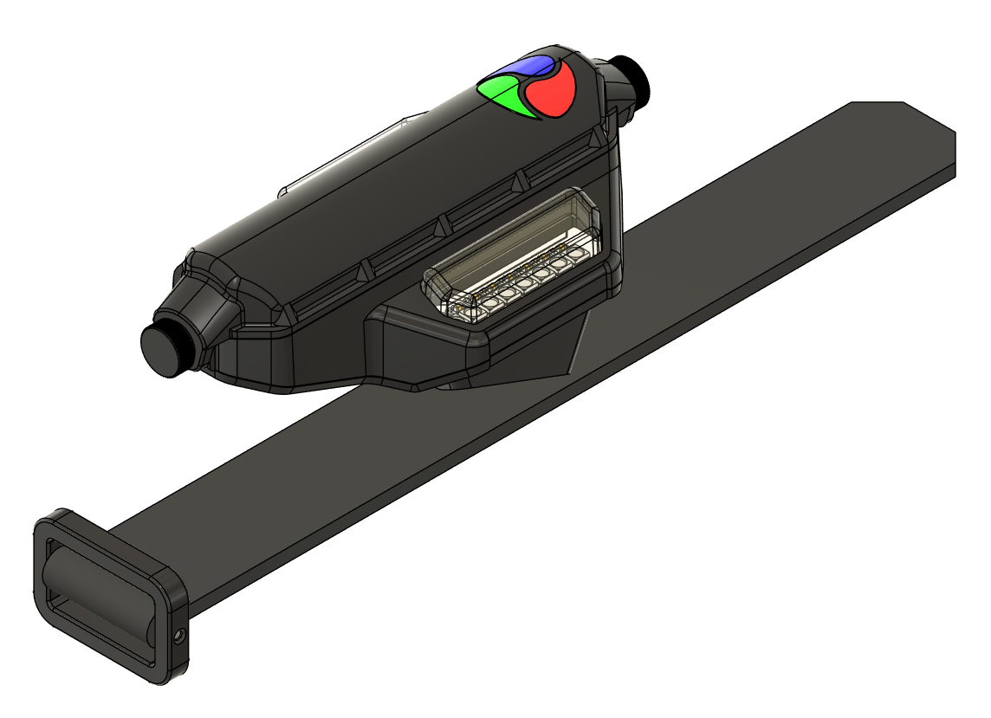
Mechanical/Media/render_enclosure.PNG
