Hao-Xuan/Reactor-Bike-Light/Mobile App/Media/app_main.jpg

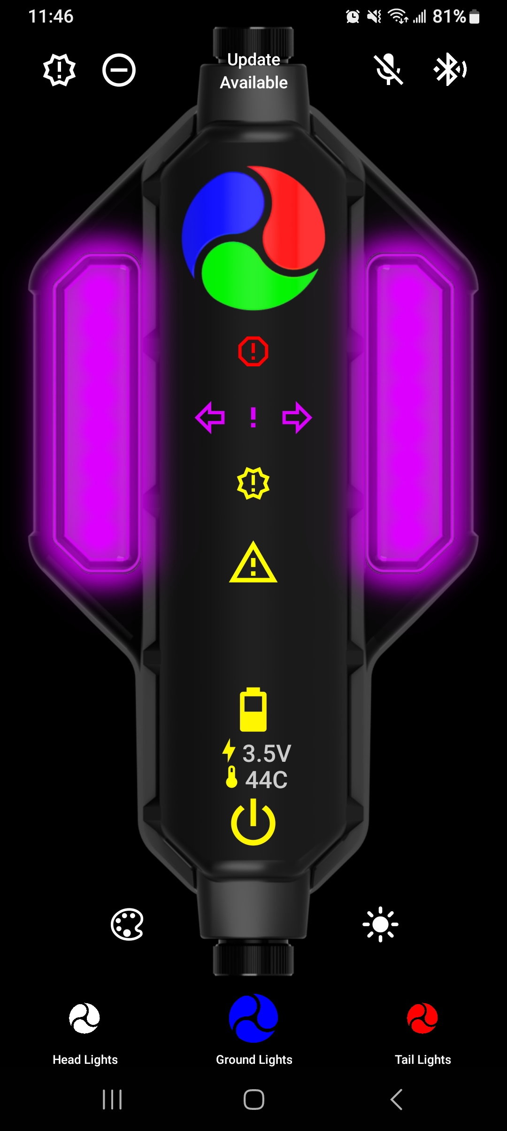
Mobile App/Media/app_main.jpg
