Hao-Xuan/Reactor-Bike-Light/Device Firmware/Media/validation_i2c_protocol.png

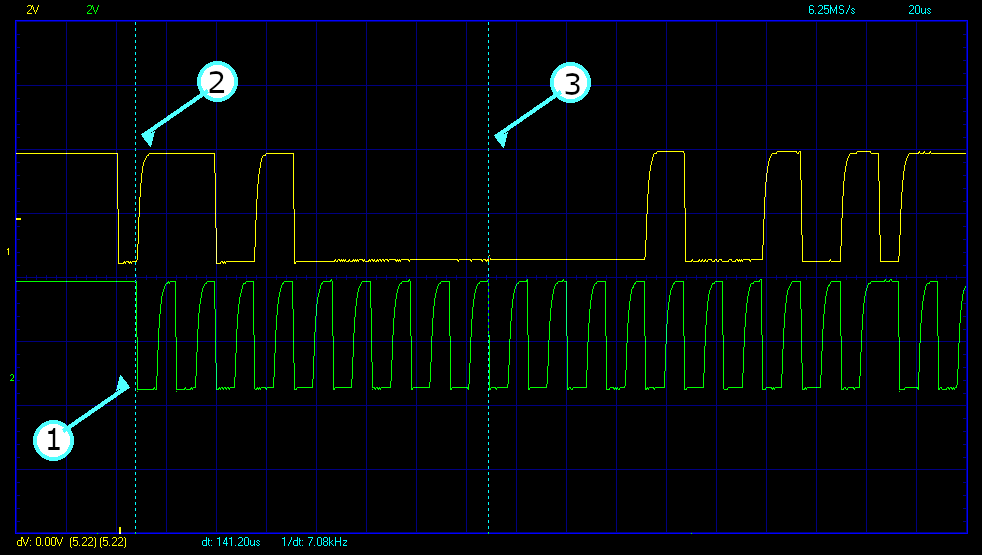
Device Firmware/Media/validation_i2c_protocol.png
