Hao-Xuan/Reactor-Bike-Light/Device Firmware/Media/validation_ipc_latency.png

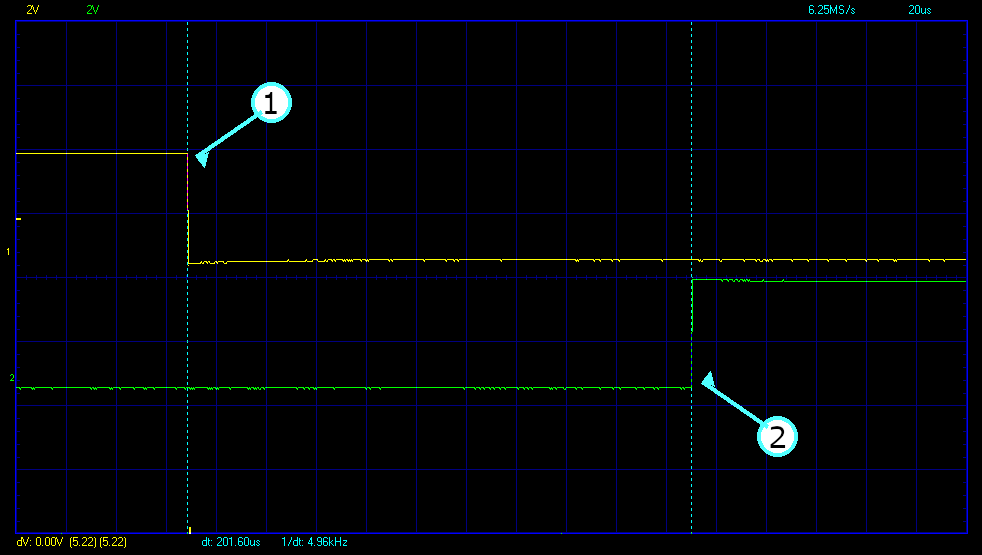
Device Firmware/Media/validation_ipc_latency.png
