Hao-Xuan/Reactor-Bike-Light/Device Firmware/Media/validation_ipc_synchronization.png

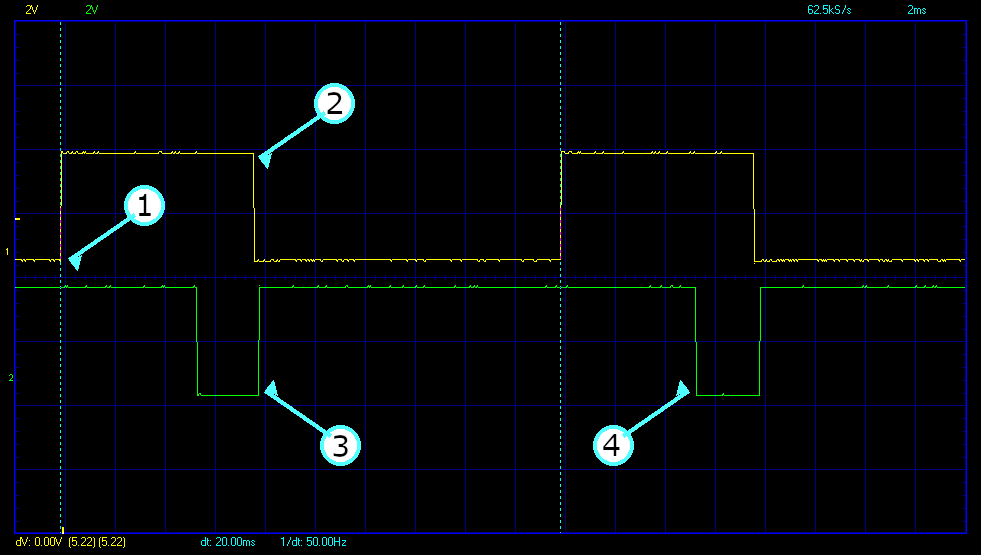
Device Firmware/Media/validation_ipc_synchronization.png
