Hao-Xuan/Reactor-Bike-Light/Device Firmware/Media/validation_nrz_protocol.png

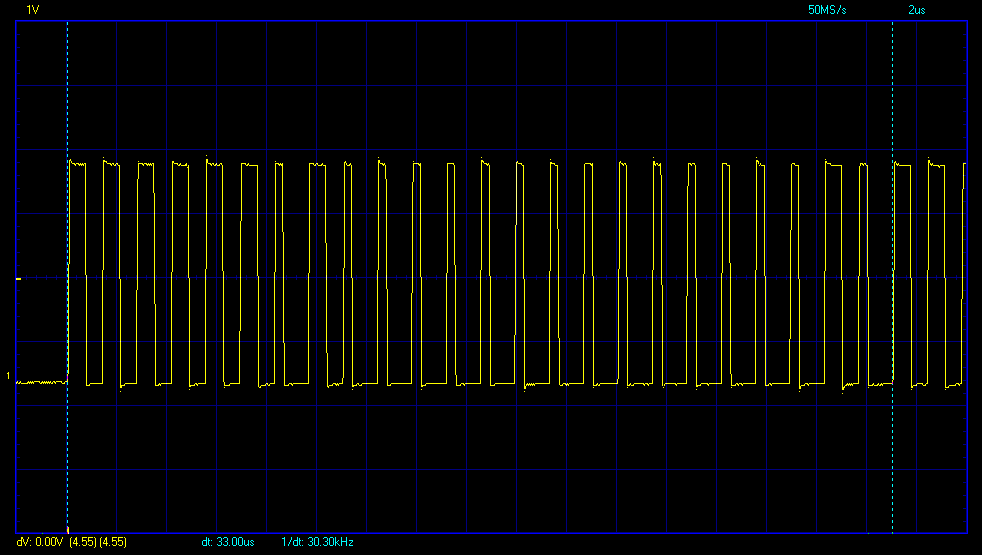
Device Firmware/Media/validation_nrz_protocol.png
