Hao-Xuan/Reactor-Bike-Light/Device Firmware/Media/validation_uart_baud.png

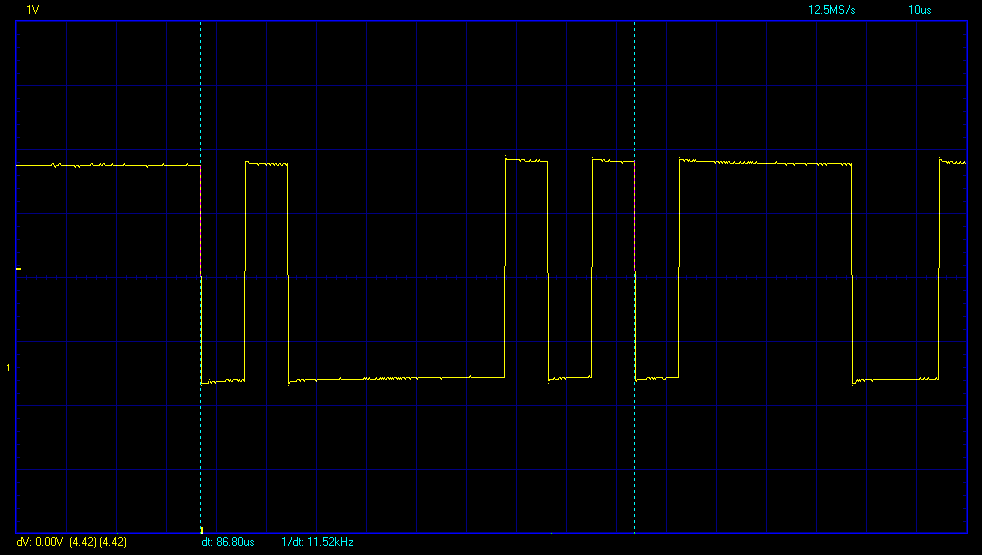
Device Firmware/Media/validation_uart_baud.png
