Hao-Xuan/Reactor-Bike-Light/(commit log)

2026-05-26 Enhance README with detailed project overview
    Expanded the README with detailed sections on project description, architecture, sensors, motion processing, control cores, LED behavior, BLE communication, and mobile app functionalities.
2026-05-26 Sample code for Reactor showcase
    Includes propeller files for main, sensors, fusion, LED, and BLE control. Includes JavaScript files for bike light model, BLE utilities, local store and state management.
2026-05-26 Media file upload
    Added block diagram and pictures of designs and real devices.
2026-05-27 Add app screenshot
    Screenshot of ground light
2026-05-28 Improve clarity and conciseness in README.md
    Refined language for clarity and conciseness throughout the README. Updated sections on device modes, system architecture, and BLE communication.
2026-06-04 Revise synchronization and I2C implementation details in README
    Updated the README to enhance the synchronization and I2C implementation sections with new figures and explanations.
2026-06-05 Enhance readme.md with firmware details
    Added detailed information about the device firmware, including included modules and purpose.
2026-06-05 Add readme for Device Firmware directory
    This readme provides an overview of the device firmware structure and its components.
2026-06-10 Update README to remove 'sensor fusion' reference
    Removed mention of sensor fusion in the description.
2026-06-28 Add initial readme for Hardware section
    This section currently under construction. Come back later to see the design process and current state of the Reactor Bike Light hardware.
2026-07-01 Enhance electronics readme with architecture details
    Expanded the electronics overview section to include detailed descriptions of the architecture, power source, and operational domains of Reactor's electronic system.
2026-07-02 Enhance readme with Power Source and Always-On Domain details
    Expanded details on Power Source and Always-On Domain subsystems, including battery specifications, input protection, and touch sensing logic.
2026-07-02 Enhance Always-On Domain documentation
    Updated the Always-On Domain section with additional details and an updated schematic image.
2026-07-02 Replace schematic image in readme.md
    Updated the schematic image for the Always-On Domain section.
2026-07-08 Added PCB layout documentation
2026-07-10 Added annotated images
    and moved enclosure media
2026-07-13 Revise readme with detailed electronics architecture
    Removed placeholder text and added detailed descriptions of the electronic system's architecture, power distribution, and components. Updated figures and clarified operational details for various power domains.
2026-07-14 Revise PCB layout section in readme
    Updated PCB layout details and images in the readme.
2026-07-14 Updated Annotated PCB view
2026-07-15 Refine PCB layout descriptions for conciseness
    Removed redundant sentences for clarity in PCB layout descriptions.
2026-07-15 Enhance readme with development and testing details
    Updated the readme to include development hardware details, board bring-up process, and validation methods for the Reactor PCB. Added figures and clarified the testing section.
2026-07-16 Revise electronics readme for clarity on versions
    Updated the readme to include production and development board details.
2026-08-20 Fix formatting and enhance clarity in readme
    Corrected capitalization in section headers and improved clarity in the board bring-up process descriptions.
2026-08-22 Enhance readme with power management and implementation details
    Expanded the readme with implementation highlights, power management details, unit initialization, continuous power supervision, and controlled shutdown processes.
2026-08-25 Enhance readme with detailed firmware implementation info
    Expanded the readme to include detailed sections on inter-core communication, power management, finite state machines, and firmware updates. Added examples and explanations for various control processes and IPC mechanisms used in the Reactor firmware.
2026-08-28 Refactor readme.md for improved clarity and structure
    Updated section headers for consistency and clarity, and refined descriptions of firmware architecture, sensor acquisition, and firmware update processes.
2026-08-31 Revise I2C driver and document NRZ LED timing
    Updated the I2C implementation details and added validation for the NRZ LED driver. Enhanced explanations of timing and data transmission processes.
2026-09-02 Update readme.md to remove old ADC code example
    Remove outdated example code for battery ADC measurement.
2026-09-08 Reorganized Firmware Source Code Samples
2026-09-08 Enhance readme with engineering challenges details
    Expanded the engineering challenges section to include details on the complementary filter implementation and its comparison with a Kalman filter for motion estimation. Added links to relevant code samples for further reference.
